Saie12/KiCAD-Home-Automation-with-ESP32-Project/(commit log)

2025-07-22 Placed MCU (ESP32-WROOM-32) in Schematic
    [Home Automation with ESP32.kicad_sch]
2025-07-22 Placed Isolator (PC817) in Schematic
    [Home Automation with ESP32.kicad_sch]
2025-07-22 Placed Linear Regulator (AMS1117-3.3) in Schematic
    [Home Automation with ESP32.kicad_sch]
2025-07-22 Placed AC/DC Converter (HLK-PM01) in Schematic
    [Home Automation with ESP32.kicad_sch]
2025-07-23 Placed Power Relay (RAYEX-L90AS) in Schematic
    [Home Automation with ESP32.kicad_sch]
2025-07-23 Added pr13-5v-450-1c symbol to library
2025-07-23 Placed SPDT Power Relay (pr13-5v-450-1c) in Schematic
    [Home Automation with ESP32.kicad_sch]
2025-07-23 Added pr13-5v-450-1c footprint to Footprints Folder
2025-07-23 Placed Transistor (S8050) in Schematic
    [Home Automation with ESP32.kicad_sch]
2025-07-23 Placed SW_PUSH in Schematic
    [Home Automation with ESP32.kicad_sch]
2025-07-23 Placed Diodes in Schematic
    [Home Automation with ESP32.kicad_sch]
2025-07-26 Placed Capacitors in Schematic
    [Home Automation with ESP32.kicad_sch]
2025-07-26 Placed Wires for Power Supply in Schematic
    [Home Automation with ESP32.kicad_sch]
2025-07-26 Placed PWR_flag and GND in Schematic
    [Home Automation with ESP32.kicad_sch]
2025-07-26 Placed Net Labels in Power Supply in Schematic
    [Home Automation with ESP32.kicad_sch]
2025-07-26 Values to Capacitor of PowerSupply in Schematic
    [Home Automation with ESP32.kicad_sch]
2025-07-26 Power Supply completed in Schematic
    [Home Automation with ESP32.kicad_sch]
2025-07-26 Placed Resistors in Schematic
    [Home Automation with ESP32.kicad_sch]
2025-07-26 Placed Wires for Relay-1 in Schematic
    [Home Automation with ESP32.kicad_sch]
2025-07-26 Placed GND in Schematic
    [Home Automation with ESP32.kicad_sch]
2025-07-26 Placed Net Labels in Relay-1 in Schematic
    [Home Automation with ESP32.kicad_sch]
2025-07-26 Relay-1 Completed in Schematic
    [Home Automation with ESP32.kicad_sch]
2025-07-26 Placed WIres for Relay-2 in Schematic
    [Home Automation with ESP32.kicad_sch]
2025-07-26 Placed GND and Net Labels in Schematic in Relay-2
    [Home Automation with ESP32.kicad_sch]
2025-07-26 Relay-2 Completed in Schematic
    [Home Automation with ESP32.kicad_sch]
2025-07-27 Placed Resistor in Schematic
    [Home Automation with ESP32.kicad_sch]
2025-07-27 Placed LED's in Schematic
    [Home Automation with ESP32.kicad_sch]
2025-07-27 WIred for LED's in Schematic
    [Home Automation with ESP32.kicad_sch]
2025-07-27 Added Net Labels in Schematic
    [Home Automation with ESP32.kicad_sch]
2025-08-23 Routing completed of RESET & BOOT Schematic
2025-08-23 Schematic Connection completed for Switches
    [Home Automation with ESP32.kicad_sch]
2025-08-23 Schematic Connection completed for UART
    [Home Automation with ESP32.kicad_sch]
2025-08-23 Schematic Connection completed for ESP-32
    [Home Automation with ESP32.kicad_sch]
2025-08-23 Placed the Mounting_Pad in Schematic
    [Home Automation with ESP32.kicad_sch]
2025-08-23 Naming in Schematic is Completed
    [Home Automation with ESP32.kicad_sch]
2025-08-24 assigned the footprints to in schematic
    [Home Automation with ESP32.kicad_sch]
2025-08-24 ERC with 0 Errors Successful
    [Home Automation with ESP32.kicad_sch]
2025-08-24 Placed the components in PCB Editor
    [Home Automation with ESP32.kicad_pcb]
2025-08-24 Added Edge Cuts/Outline
    [Home Automation with ESP32.kicad_pcb]
2025-08-24 Made Edge Cut for the Relay K2
    [Home Automation with ESP32.kicad_pcb]
2025-08-24 Made Tracks and Copper Field Zones in PCB Editor
    [Home Automation with ESP32.kicad_pcb]
2025-08-31 Assigned the Footprints
    [Home Automation with ESP32.kicad_pcb]
